alru-git/stockwaage/docs/fotos/IMG_6067.JPG

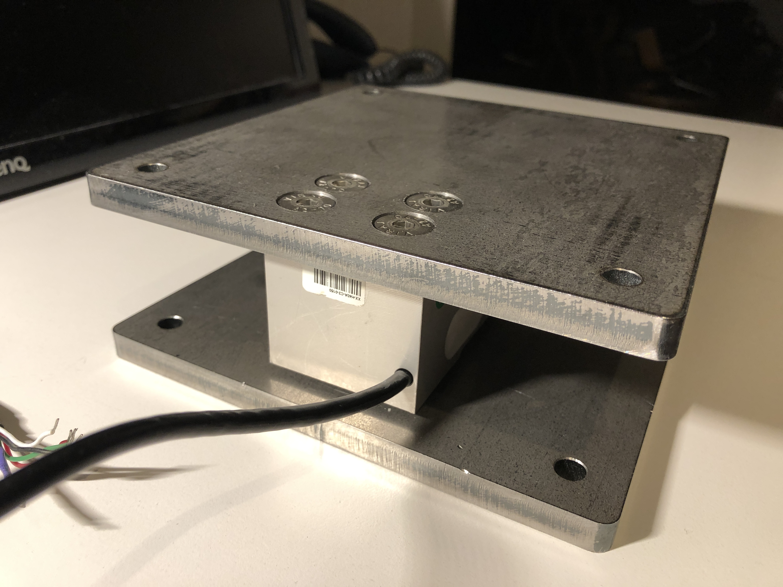
docs/fotos/IMG_6067.JPG
