alru-git/stockwaage/docs/fotos/IMG_6076.JPG

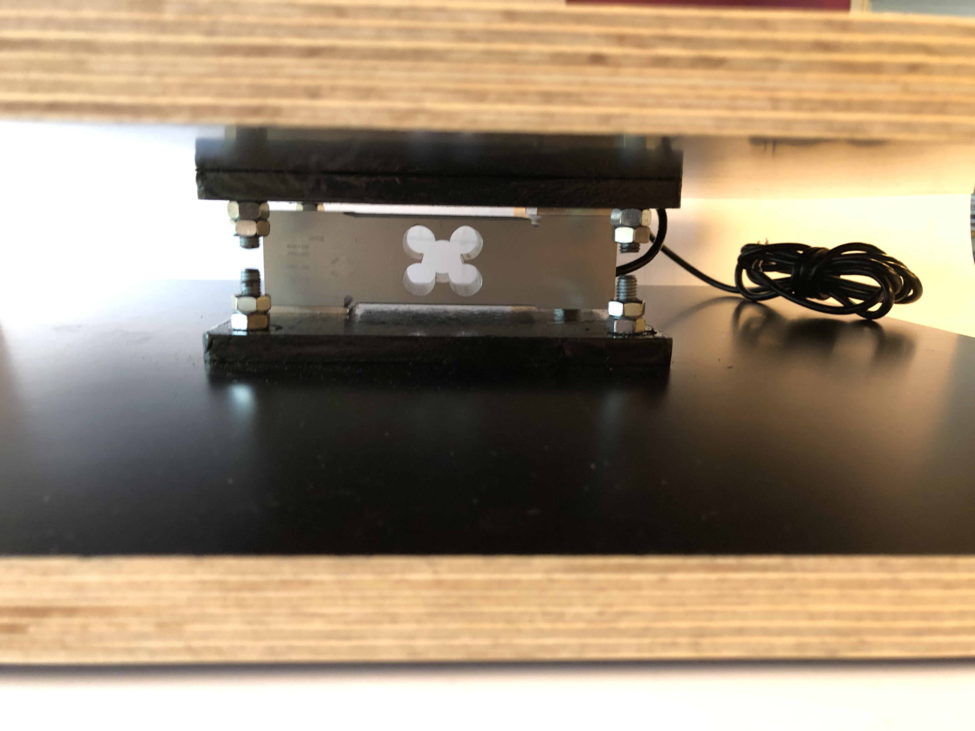
docs/fotos/IMG_6076.JPG
