alru-git/stockwaage/README.md

# Stockwaage

Die Stockwaage misst folgende Größen:
- Gewicht des Bienenstocks
- Temperatur im Bienenstock
- Luftfeuchtigkeit im Bienenstock
- Spannungsversorgung (Spg.-Ausgang des Solar-Ladereglers)

Die Daten des Prototypen sind hier online:
https://www.alru.de/bienen/stockwaage1_graph.php

Genutzte Technologien:
- Arduino (Controller für die Sensoren, https://docs.arduino.cc/retired/boards/arduino-pro-mini)
- Mysensors (Radio Gateway, https://www.mysensors.org/)
- Fhem (Hausautomation Controller, https://fhem.de/)
- Datenvisualisierung im Web, https://www.chartjs.org

Inhalt:
- /docs: Dokumentation des Projektes
- /src: Code
