alru-git/stockwaage/docs/README.md

# Inhalt:
- /docu: Dokumentationen und Präsentationen

- /fotos: Alle Bauteilefotos

- /wiring: Schaltpläne (.pdf), inkl. Source Files (.json), erstellt mit EasyEDA https://easyeda.com/
