alru-git/stockwaage/docs/fotos/IMG_6069.JPG

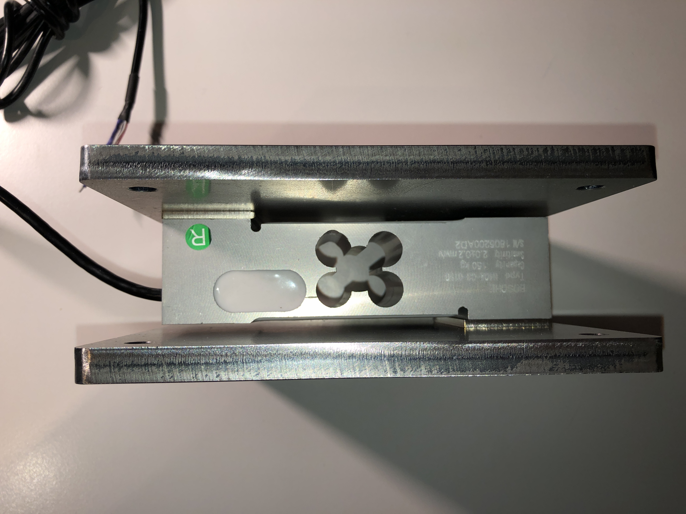
docs/fotos/IMG_6069.JPG
