alru-git/stockwaage/docs/fotos/IMG_6072.JPG

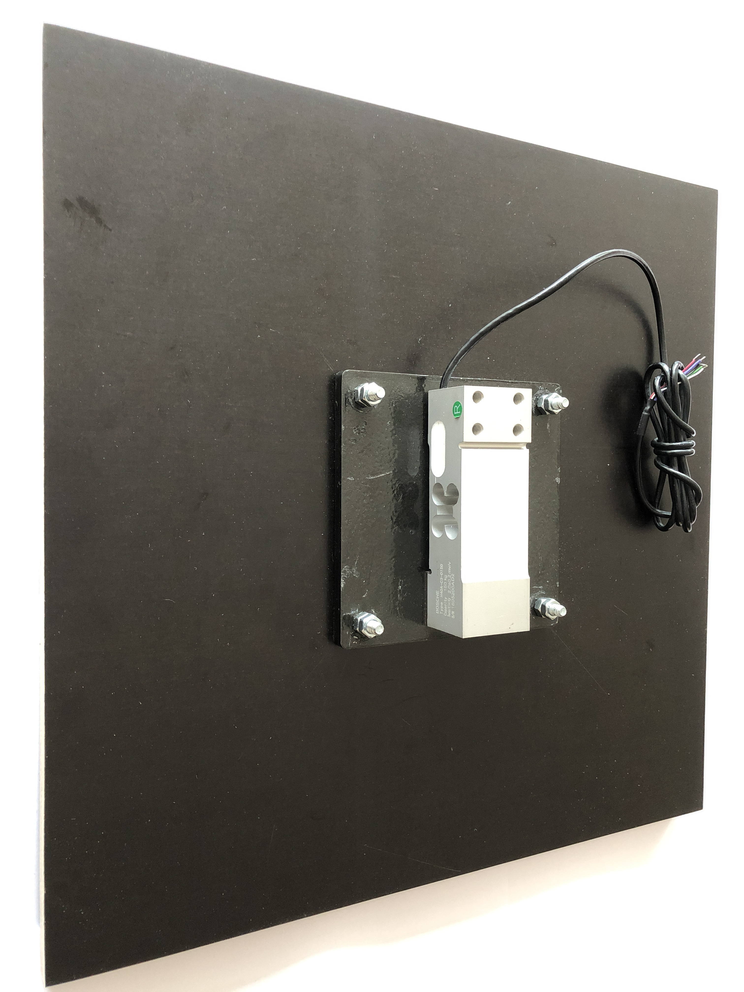
docs/fotos/IMG_6072.JPG
