alru-git/stockwaage/docs/fotos/IMG_6075.JPG

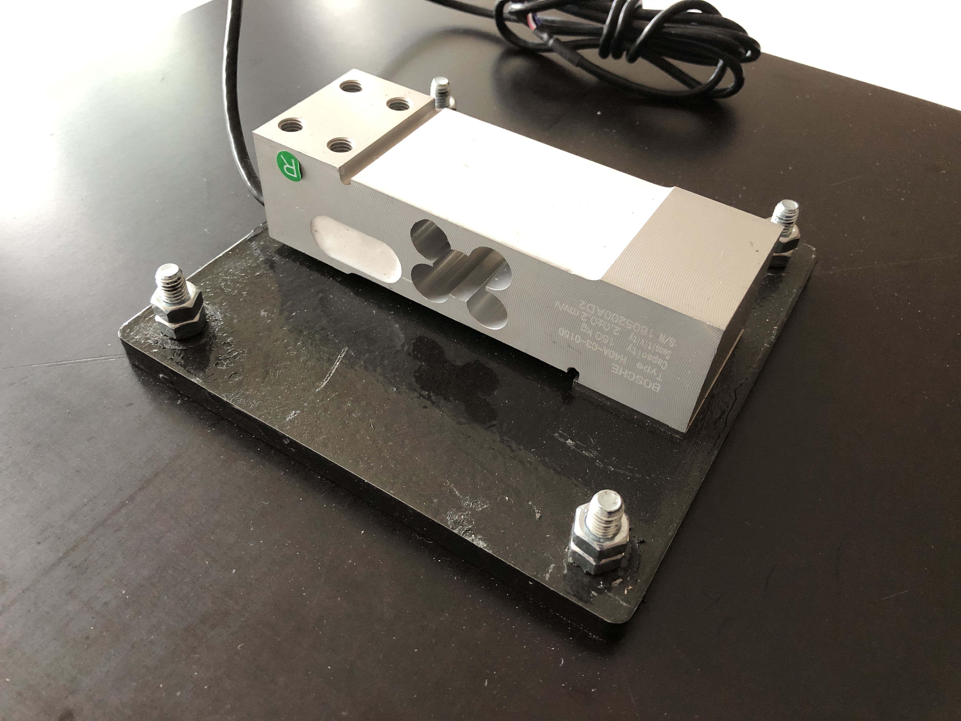
docs/fotos/IMG_6075.JPG
