alru-git/stockwaage/docs/fotos/IMG_6077.JPG

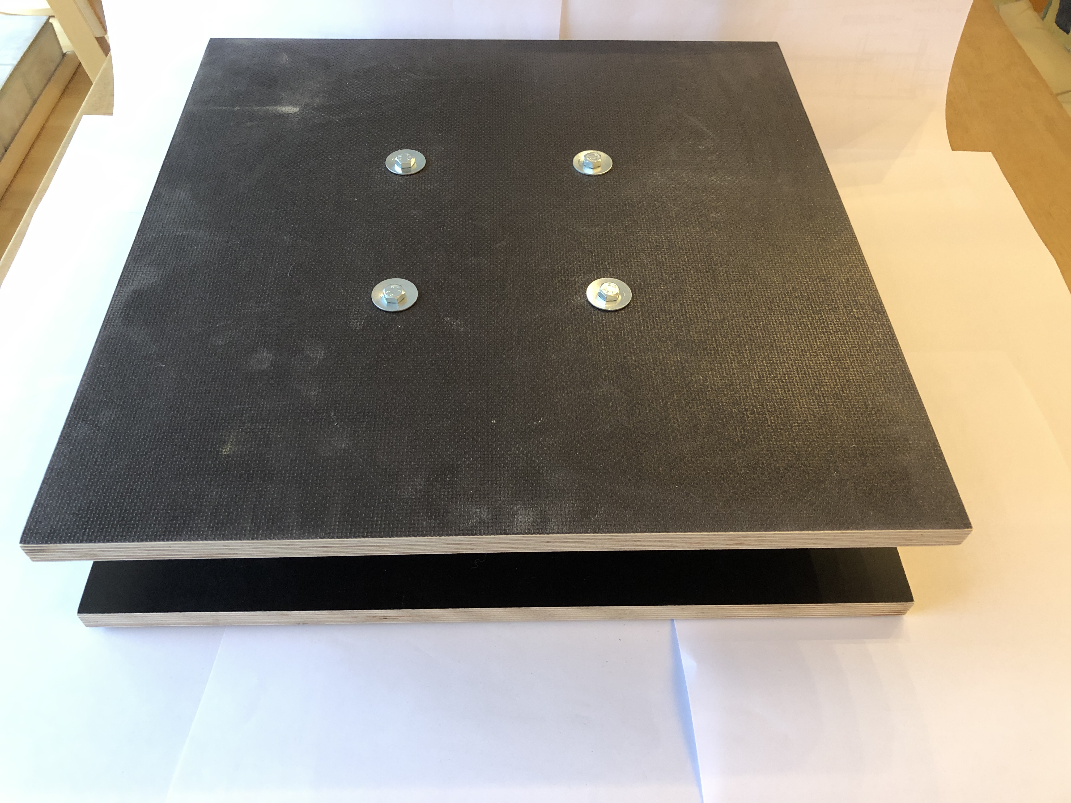
docs/fotos/IMG_6077.JPG
