alru-git/stockwaage/docs/wiring/Stockwaage_Schematic_Sheet_ver_1_7.pdf

## Funkmodul

## 12V Spannungsversorgung

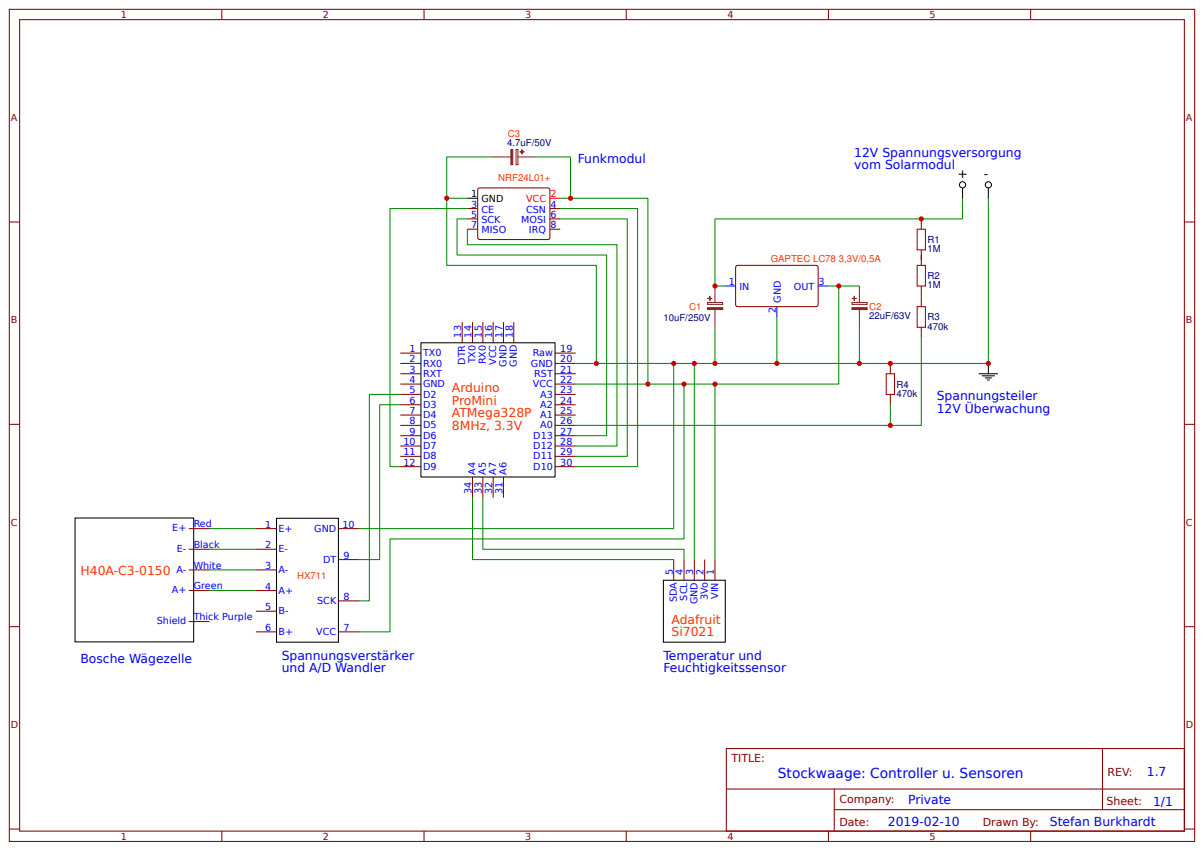
[picture p7: page 1]

GND 3 SCL 4 SDA 5 Adafruit

und A/D Wandler Bosche Wägezelle

Drawn By: Stefan Burkhardt
