alru-git/stockwaage/(list of files, drawings)

Other design files:
docs/wiring/Stockwaage_Schematic_EasyEDA_ver_1_7.json
