alru-git/stockwaage/(notices)

Notices in the files:
src/Stockwaage1.ino:
modify it under the terms of the GNU General Public License
